numnahboom/rv32i_int8_dsc_cnn_accelerator/docs/reports/synthesis_vivado_ds_block_tile_engine_new.md

# Vivado Initial Synthesis Report

- Date: 2026-07-17T12:31:50+0800
- Tool: Vivado 2021.2
- Top module: `ds_block_tile_engine_new`
- Part: `xck26-sfvc784-2LV-c`
- Clock constraint: 10.000 ns
- Status: PASSED
- Timing summary: FAILED: ERROR: [Common 17-577] Internal error: Cannot run timing on a non-timing device

- Clock utilization report: FAILED: ERROR: [Common 17-577] Internal error: Cannot run timing on a non-timing device

- Checkpoint write: FAILED: ERROR: [Common 17-577] Internal error: Cannot run timing on a non-timing device

## Quick Counts

| Metric | Value |
| --- | ---: |
| LUT primitive cells | 29823 |
| FF/latch primitive cells | 15649 |
| BRAM-like primitive cells | 26 |
| DSP primitive cells | 14 |
| Worst observed max-path slack | unknown ns |

## Generated Reports

- `build/reports/vivado_ds_block_tile_engine_new/utilization.txt`
- `build/reports/vivado_ds_block_tile_engine_new/utilization_hierarchical.txt`
- `build/reports/vivado_ds_block_tile_engine_new/timing_summary.txt`
- `build/reports/vivado_ds_block_tile_engine_new/clock_utilization.txt`
- `build/reports/vivado_ds_block_tile_engine_new/ds_block_tile_engine_new_synth.dcp` if checkpoint write passed

## Notes

This is an initial synthesis-only result. It is not post-place-and-route timing and does not include board-level IO constraints.
