numnahboom/rv32i_int8_dsc_cnn_accelerator/docs/reports/synthesis_vivado_ds_block_tile_engine.md

# Vivado Initial Synthesis Report

- Date: 2026-06-16T16:20:15+0800
- Tool: Vivado 2021.2
- Top module: `ds_block_tile_engine`
- Part: `xck26-sfvc784-2LV-c`
- Clock constraint: 10.000 ns
- Status: PASSED
- Timing summary: FAILED: ERROR: [Common 17-577] Internal error: Cannot run timing on a non-timing device

- Clock utilization report: FAILED: ERROR: [Common 17-577] Internal error: Cannot run timing on a non-timing device

- Checkpoint write: FAILED: ERROR: [Common 17-577] Internal error: Cannot run timing on a non-timing device

## Quick Counts

| Metric | Value |
| --- | ---: |
| LUT primitive cells | 645195 |
| FF/latch primitive cells | 565654 |
| BRAM-like primitive cells | 0 |
| DSP primitive cells | 20 |
| Worst observed max-path slack | unknown ns |

## Generated Reports

- `build/reports/vivado_ds_block_tile_engine/utilization.txt`
- `build/reports/vivado_ds_block_tile_engine/utilization_hierarchical.txt`
- `build/reports/vivado_ds_block_tile_engine/timing_summary.txt`
- `build/reports/vivado_ds_block_tile_engine/clock_utilization.txt`
- `build/reports/vivado_ds_block_tile_engine/ds_block_tile_engine_synth.dcp` if checkpoint write passed

## Notes

This is an initial synthesis-only result. It is not post-place-and-route timing and does not include board-level IO constraints.
