numnahboom/rv32i_int8_dsc_cnn_accelerator/docs/reports/synthesis_vivado_dw_tile_fusion_engine.md

# Vivado Initial Synthesis Report

- Date: 2026-06-16T10:10:34+0800
- Tool: Vivado 2021.2
- Top module: `dw_tile_fusion_engine`
- Part: `xck26-sfvc784-2LV-c`
- Clock constraint: 10.000 ns
- Status: PASSED
- Timing summary: FAILED: ERROR: [Common 17-577] Internal error: Cannot run timing on a non-timing device

- Clock utilization report: FAILED: ERROR: [Common 17-577] Internal error: Cannot run timing on a non-timing device

- Checkpoint write: FAILED: ERROR: [Common 17-577] Internal error: Cannot run timing on a non-timing device

## Quick Counts

| Metric | Value |
| --- | ---: |
| LUT primitive cells | 307455 |
| FF/latch primitive cells | 296388 |
| BRAM-like primitive cells | 0 |
| DSP primitive cells | 10 |
| Worst observed max-path slack | unknown ns |

## Generated Reports

- `build/reports/vivado_dw_tile_fusion_engine/utilization.txt`
- `build/reports/vivado_dw_tile_fusion_engine/utilization_hierarchical.txt`
- `build/reports/vivado_dw_tile_fusion_engine/timing_summary.txt`
- `build/reports/vivado_dw_tile_fusion_engine/clock_utilization.txt`
- `build/reports/vivado_dw_tile_fusion_engine/dw_tile_fusion_engine_synth.dcp` if checkpoint write passed

## Notes

This is an initial synthesis-only result. It is not post-place-and-route timing and does not include board-level IO constraints.
