numnahboom/rv32i_int8_dsc_cnn_accelerator/docs/reports/assets/d4_asic_area_tradeoffs_20261020.pdf

Four partial
products

Native full
signed32
TT, 8 ns; mapped standard cells

0.00

0.02

0.04

0.06

0.08

Are

a (m

m2

)

0.0762

0.0619

18.70% smaller

### Isolated RQ lane

3 x 2048
words

2048/1024/2048
words
Exact LEF/Liberty placement boundary

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
a (m

m2

)

4.7156

4.0426

14.27% smaller

### Activation SRAM footprint

A2: logic
residual table

A3: 8 compiled
residual ROMs
TT, 10 ns; synthesis only

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
ell are

a (m

m2

)

9.1052

9.9230

+8.98% total

### Complete core, all storage counted

Memory macros
Combinational
Sequential

## D4 / SMIC 180 nm: measured implementation trade-offs

Same frozen network and integer semantics. Separate area scopes; no power or post-route claim. A2 numeric mapping reports retained; its mapped checkpoint was not saved. A3 checkpoint and report recovery verified.
