numnahboom/rv32i_int8_dsc_cnn_accelerator/docs/reports/assets/d4_mop_route_comparison_20261019.pdf

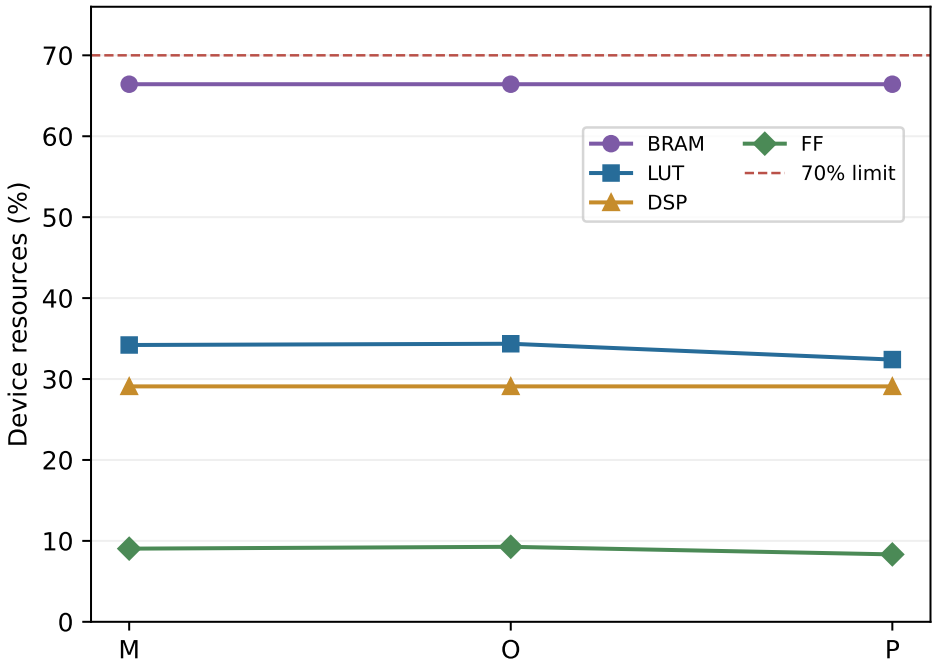
[picture p2: figure]
Device resources (%); BRAM LUT DSP; FF 70% limit

M | O | P

0.3

0.2

0.1

0.0

0.1

0.2

Post-route setup WNS (ns)

-0.287 ns

-0.221 ns

+0.128 ns

### 125 MHz synchronous setup

### Each resource stays below 70%

D4 full-route evidence: M | O | P
