numnahboom/rv32i_int8_dsc_cnn_accelerator/docs/reports/pw_partial_k_streaming_20260830.md

# PW output-stationary partial-K streaming prototype

Date: 2026-08-30  
Device: `xc7z020clg400-1`  
Clock screen: 8 ns (125 MHz)

## Scope

This is an isolated prototype for `pw_systolic_array_8x8`; it is not connected
to `ds_block_tile_engine_new`, the layer runner, or the full network. The
external block remains an 8-pixel x 8-cout transaction. The physical fabric is
8 x 4 and uses two output-channel halves.

The lower half now consumes each accepted K token immediately while a narrow
replay memory retains the token for the upper half. `first_k`/`last_k` describe
the complete reduction, while `k_group`/`k_count` describe a group. Group
boundaries never clear, close, requantize, or publish the accumulator. The
lower PE sums are captured into `first_psum` only after the final lower token's
registered PE update; the upper replay then clears the PE fabric exactly once
on its first token and retains its psum across all group boundaries. Legacy
`clear_acc`/`k_last` remains selected when `k_count==0`.
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
