numnahboom/rv32i_int8_dsc_cnn_accelerator/tests/fixtures/d4_activity_binding/fd_q_hierarchy_bindings.tsv

source_scope | physical_scope | expected_orig_ref | expected_parent
u_core/rq_mul_lanes[0]/rq_mul | u_core/rq_mul_lanes[0].rq_mul | d4_rq_partial_multiplier_lane | u_core
u_core/rq_mul_lanes[1]/rq_mul | u_core/rq_mul_lanes[1].rq_mul | d4_rq_partial_multiplier_lane | u_core
u_core/rq_mul_lanes[2]/rq_mul | u_core/rq_mul_lanes[2].rq_mul | d4_rq_partial_multiplier_lane | u_core
u_core/rq_mul_lanes[3]/rq_mul | u_core/rq_mul_lanes[3].rq_mul | d4_rq_partial_multiplier_lane | u_core
u_core/rq_mul_lanes[4]/rq_mul | u_core/rq_mul_lanes[4].rq_mul | d4_rq_partial_multiplier_lane | u_core
u_core/rq_mul_lanes[5]/rq_mul | u_core/rq_mul_lanes[5].rq_mul | d4_rq_partial_multiplier_lane | u_core
u_core/rq_mul_lanes[6]/rq_mul | u_core/rq_mul_lanes[6].rq_mul | d4_rq_partial_multiplier_lane | u_core
u_core/rq_mul_lanes[7]/rq_mul | u_core/rq_mul_lanes[7].rq_mul | d4_rq_partial_multiplier_lane | u_core
u_core/rq_mul_lanes[8]/rq_mul | u_core/rq_mul_lanes[8].rq_mul | d4_rq_partial_multiplier_lane | u_core
u_core/rq_mul_lanes[9]/rq_mul | u_core/rq_mul_lanes[9].rq_mul | d4_rq_partial_multiplier_lane | u_core
u_core/rq_mul_lanes[10]/rq_mul | u_core/rq_mul_lanes[10].rq_mul | d4_rq_partial_multiplier_lane | u_core
u_core/rq_mul_lanes[11]/rq_mul | u_core/rq_mul_lanes[11].rq_mul | d4_rq_partial_multiplier_lane | u_core
u_core/rq_mul_lanes[12]/rq_mul | u_core/rq_mul_lanes[12].rq_mul | d4_rq_partial_multiplier_lane | u_core
u_core/rq_mul_lanes[13]/rq_mul | u_core/rq_mul_lanes[13].rq_mul | d4_rq_partial_multiplier_lane | u_core
u_core/rq_mul_lanes[14]/rq_mul | u_core/rq_mul_lanes[14].rq_mul | d4_rq_partial_multiplier_lane | u_core
u_core/rq_mul_lanes[15]/rq_mul | u_core/rq_mul_lanes[15].rq_mul | d4_rq_partial_multiplier_lane | u_core
