numnahboom/rv32i_int8_dsc_cnn_accelerator/rtl/cnn/ds12_stream_ds1_layer.v

`timescale 1ns/1ps
`default_nettype none
module ds12_stream_ds1_layer #(
    parameter integer INPUT_BASE = 0,
    parameter integer SINK_BASE = 32'h00100000
) (
    input wire clk,input wire rst_n,input wire start,
    output wire cfg_mem_req_valid,input wire cfg_mem_req_ready,output wire [31:0] cfg_mem_req_addr,output wire [3:0] cfg_mem_req_strb,output wire [1:0] cfg_mem_req_layer,output wire [15:0] cfg_mem_req_word_index,input wire cfg_mem_resp_valid,input wire [31:0] cfg_mem_resp_data,
    output wire input_mem_req_valid,input wire input_mem_req_ready,output wire input_mem_req_write,output wire [31:0] input_mem_req_addr,output wire [127:0] input_mem_req_wdata,output wire [15:0] input_mem_req_strb,output wire [1:0] input_mem_req_context,output wire input_mem_req_owner,output wire [31:0] input_mem_req_epoch,input wire input_mem_resp_valid,input wire [127:0] input_mem_resp_data,
    output wire output_write_valid,input wire output_ready,output wire output_write_bank,output wire [31:0] output_write_epoch,output wire [31:0] output_write_addr,output wire [31:0] output_write_data,output wire [3:0] output_write_be,output wire output_write_last,
    output wire layer_done,output wire error,output wire ds1_config_done,output wire ds2_preload_done,output wire [31:0] cycle_count,output wire [31:0] dw_first_cycle,output wire [31:0] dw_last_cycle,output wire [31:0] pw_first_cycle,output wire [31:0] pw_last_cycle,output wire [31:0] overlap_cycles,output wire [31:0] dw_idle_cycles,output wire [31:0] pw_idle_cycles,output wire [31:0] dw_mac_count,output wire [31:0] pw_mac_count,output wire [31:0] output_word_count,output wire [31:0] config_read_count,output wire [31:0] config_write_count,output wire [1:0] active_config_layer,output wire [31:0] active_config_epoch,output wire active_config_bank,output wire [1:0] activation_bank0_state,output wire [1:0] activation_bank1_state,output wire [31:0] activation_write_count,output wire activation_commit_done,output wire [31:0] activation_write_expected_bytes,output wire activation_write_last_seen,output wire [31:0] ds1_input_read_count,output wire [31:0] ds1_dw_vector_count
);
  wire d_clv,d_clr; wire [1:0] d_cllayer; wire [31:0] d_cle; wire [15:0] d_clcount;
  wire c_req_v,c_req_r,c_resp_r,c_rd_en,c_rd_v,c_rd_bank,c_load_done,c_err,c_act_valid; wire [31:0] c_req_addr,c_rd_data,c_act_epoch; wire [3:0] c_req_strb,c_errcode; wire [15:0] c_req_idx,c_rd_addr; wire [1:0] c_act_layer,c_bank_valid; wire c_act_bank,c_busy; wire [15:0] c_issued,c_received;
  function automatic [31:0] src_addr(input [1:0] l,input [15:0] i);
    begin if(l==1) begin if(i<36)src_addr=32'h3000+i*4; else if(i<52)src_addr=32'h3100+(i-36)*4; else if(i<68)src_addr=32'h3140+(i-52)*4; else if(i<84)src_addr=32'h3180+(i-68)*4; else if(i<212)src_addr=32'h3200+(i-84)*4; else if(i<244)src_addr=32'h3400+(i-212)*4; else if(i<276)src_addr=32'h3480+(i-244)*4; else src_addr=32'h3500+(i-276)*4; end else begin if(i<72)src_addr=32'h4000+i*4; else if(i<104)src_addr=32'h4200+(i-72)*4; else if(i<136)src_addr=32'h4280+(i-104)*4; else if(i<168)src_addr=32'h4300+(i-136)*4; else if(i<424)src_addr=32'h4400+(i-168)*4; else if(i<488)src_addr=32'h4c00+(i-424)*4; else if(i<552)src_addr=32'h4d00+(i-488)*4; else src_addr=32'h4e00+(i-552)*4; end end
  endfunction
  assign cfg_mem_req_valid=c_req_v; assign cfg_mem_req_addr=src_addr(d_cllayer,c_req_idx); assign cfg_mem_req_strb=c_req_strb; assign cfg_mem_req_layer=d_cllayer; assign cfg_mem_req_word_index=c_req_idx; assign c_req_r=cfg_mem_req_ready;
  ds12_stream_config_banks cfg(.clk(clk),.rst_n(rst_n),.start(d_clv),.start_layer(d_cllayer),.start_base_addr(0),.start_word_count(d_clcount),.start_epoch(d_cle),.start_ready(d_clr),.mem_req_valid(c_req_v),.mem_req_ready(c_req_r),.mem_req_addr(c_req_addr),.mem_req_strb(c_req_strb),.mem_req_word_index(c_req_idx),.mem_resp_valid(cfg_mem_resp_valid),.mem_resp_ready(c_resp_r),.mem_resp_rdata(cfg_mem_resp_data),.commit_req(0),.clear_error(0),.cfg_rd_en(c_rd_en),.cfg_rd_bank(c_rd_bank),.cfg_rd_addr(c_rd_addr),.cfg_rd_data(c_rd_data),.cfg_rd_valid(c_rd_v),.busy(c_busy),.active_bank(c_act_bank),.active_layer(c_act_layer),.active_epoch(c_act_epoch),.active_valid(c_act_valid),.bank_valid(c_bank_valid),.expected_count(),.issued_count(c_issued),.received_count(c_received),.load_crc32(),.load_done(c_load_done),.error(c_err),.error_code(c_errcode));
  wire d_rd_v,d_rd_r,d_resp_v; wire [15:0] d_rd_addr; wire [31:0] d_resp_data; wire d_pf_v,d_pf_r; wire [1:0] d_pf_l; wire [31:0] d_pf_e; wire [15:0] d_pf_n; reg d2_done;
  wire d_as_v,d_as_r,d_aw_v,d_aw_r,d_aw_bank,d_aw_last,d_aw_drain,d_commit_v,d_commit_ack; wire [31:0] d_aw_addr,d_aw_data,d_aw_epoch,d_aw_count,d_owner_epoch,d_cfg_reads,d_cfg_writes; wire [3:0] d_aw_be; wire [1:0] d_owner;
  wire a_start_r,a_write_r,a_commit_done,a_err,a_last; wire [1:0] a_b0,a_b1; wire [31:0] a_wc,a_we;
  assign d_rd_r=1'b1; assign c_rd_en=d_rd_v; assign c_rd_bank=c_act_bank; assign c_rd_addr=d_rd_addr; assign d_resp_v=c_rd_v; assign d_resp_data=c_rd_data; assign d_pf_r=d_clr; assign d_as_r=a_start_r; assign d_aw_r=a_write_r&&output_ready; assign d_commit_ack=a_commit_done;
  ds12_stream_ds1_datapath #(.INPUT_BASE(INPUT_BASE),.SINK_BASE(SINK_BASE)) dp(.clk(clk),.rst_n(rst_n),.start(start),.cfg_load_req_valid(d_clv),.cfg_load_req_ready(d_clr),.cfg_load_req_layer(d_cllayer),.cfg_load_req_epoch(d_cle),.cfg_load_req_count(d_clcount),.cfg_load_done(c_load_done),.cfg_error(c_err),.cfg_active_rd_valid(d_rd_v),.cfg_active_rd_ready(d_rd_r),.cfg_active_rd_addr(d_rd_addr),.cfg_active_rd_resp_valid(d_resp_v),.cfg_active_rd_resp_data(d_resp_data),.ds2_prefetch_req_valid(d_pf_v),.ds2_prefetch_req_ready(d_pf_r),.ds2_prefetch_req_layer(d_pf_l),.ds2_prefetch_req_epoch(d_pf_e),.ds2_prefetch_req_count(d_pf_n),.ds2_prefetch_done(d2_done),.input_mem_req_valid(input_mem_req_valid),.input_mem_req_ready(input_mem_req_ready),.input_mem_req_write(input_mem_req_write),.input_mem_req_addr(input_mem_req_addr),.input_mem_req_wdata(input_mem_req_wdata),.input_mem_req_strb(input_mem_req_strb),.input_mem_req_context(input_mem_req_context),.input_mem_req_owner(input_mem_req_owner),.input_mem_req_epoch(input_mem_req_epoch),.input_mem_resp_valid(input_mem_resp_valid),.input_mem_resp_data(input_mem_resp_data),.activation_start_valid(d_as_v),.activation_start_ready(d_as_r),.activation_write_valid(d_aw_v),.activation_write_ready(d_aw_r),.activation_write_addr(d_aw_addr),.activation_write_data(d_aw_data),.activation_write_be(d_aw_be),.activation_write_last(d_aw_last),.activation_write_bank(d_aw_bank),.activation_write_epoch(d_aw_epoch),.activation_write_count(d_aw_count),.activation_write_drain(d_aw_drain),.activation_commit_req(d_commit_v),.activation_commit_ack(d_commit_ack),.activation_owner(d_owner),.activation_epoch(d_owner_epoch),.layer_done(layer_done),.error(error),.ds1_config_done(ds1_config_done),.ds2_preload_done(ds2_preload_done),.cycle_count(cycle_count),.dw_first_cycle(dw_first_cycle),.dw_last_cycle(dw_last_cycle),.pw_first_cycle(pw_first_cycle),.pw_last_cycle(pw_last_cycle),.overlap_cycles(overlap_cycles),.dw_idle_cycles(dw_idle_cycles),.pw_idle_cycles(pw_idle_cycles),.dw_mac_count(dw_mac_count),.pw_mac_count(pw_mac_count),.output_word_count(output_word_count),.config_read_count(d_cfg_reads),.config_write_count(d_cfg_writes),.ds1_input_read_count(ds1_input_read_count),.ds1_dw_vector_count(ds1_dw_vector_count));
  assign output_write_valid=d_aw_v&&output_ready; assign output_write_bank=d_aw_bank; assign output_write_epoch=d_aw_epoch; assign output_write_addr=d_aw_addr; assign output_write_data=d_aw_data; assign output_write_be=d_aw_be; assign output_write_last=d_aw_last;
  ds12_stream_dual_vector_activation_store #(.LINE_WORDS(2048)) act(.clk(clk),.rst_n(rst_n),.layer_start_valid(d_as_v),.layer_start_ready(a_start_r),.layer_start_bank(1),.layer_start_epoch(1),.layer_start_expected_words(8192),.write_valid(d_aw_v&&output_ready),.write_ready(a_write_r),.write_bank(d_aw_bank),.write_epoch(d_aw_epoch),.write_addr(d_aw_addr),.write_data(d_aw_data),.write_be(d_aw_be),.write_last(d_aw_last),.write_resp_valid(),.write_resp_ready(1),.write_resp_bank(),.write_resp_epoch(),.write_resp_addr(),.layer_end_valid(0),.layer_end_ready(),.layer_end_bank(0),.layer_end_epoch(0),.commit_valid(d_commit_v),.commit_ready(),.commit_bank(d_owner[0]),.commit_epoch(d_owner_epoch),.commit_done(a_commit_done),.layer_end_done(),.atomic_swap(),.read_req_valid(0),.read_req_ready(),.read_req_bank(0),.read_req_epoch(0),.read_req_addr(0),.read_resp_valid(),.read_resp_ready(1),.read_resp_data(),.read_resp_bank(),.read_resp_epoch(),.read_resp_addr(),.bank0_state(a_b0),.bank1_state(a_b1),.bank0_epoch(),.bank1_epoch(),.active_read_bank(),.active_read_epoch(),.active_write(),.active_write_bank(),.write_epoch_active(),.write_count(a_wc),.write_expected_words(a_we),.write_last_seen(a_last),.error(a_err),.error_code());
  assign activation_bank0_state=a_b0; assign activation_bank1_state=a_b1; assign activation_write_count=a_wc<<2; assign activation_write_expected_bytes=a_we<<2; assign activation_write_last_seen={31'd0,a_last}; assign activation_commit_done=commit_seen; assign active_config_layer=c_act_layer; assign active_config_epoch=c_act_epoch; assign active_config_bank=c_act_bank;
  reg d2_started;
  reg [31:0] cfg_total;
  reg commit_seen;
  assign config_read_count=cfg_total;
  assign config_write_count=cfg_total;
  always @(posedge clk) begin
    if(!rst_n) begin d2_done<=1'b0; d2_started<=1'b0; cfg_total<=0; commit_seen<=1'b0; end
    else begin
      if(d_pf_v&&d_pf_r) d2_started<=1'b1;
      if(c_load_done && (d2_started || c_act_layer==2)) d2_done<=1'b1;
      if(c_load_done) cfg_total <= cfg_total + ((d2_started || c_act_layer==2) ? 32'd872 : 32'd308);
      if(a_commit_done) commit_seen<=1'b1;
    end
  end
endmodule
`default_nettype wire
