numnahboom/rv32i_int8_dsc_cnn_accelerator/rtl/cnn/ds12_stream_ds2_pw_consumer.v

`timescale 1ns/1ps
`default_nettype none

/*
 * Stand-alone DS2 pointwise consumer.
 *
 * The DW endpoint presents two 16-byte activation slices for each pixel.
 * Eight adjacent pixels form one PW context, so the input side keeps only
 * the bounded activation scratch and its sixteen slice-valid bits.  The PW
 * engine itself is an 8x8 output-stationary array: one accepted K token
 * performs 8*8 = 64 signed INT8 MACs and K=0..31 is issued on consecutive
 * cycles.  The 64 local INT32 sums are reused for each Cout tile; at K=31
 * their *next* values are written to the selected result bank.  Consequently
 * the final product is present before a bank can become drainable.
 *
 * Two result banks provide the compute/drain ownership fence.  Each lifecycle
 * bank is 64 independent shallow depth-8 x 32-bit lane memories (not a
 * layer-sized accumulator array): one completed context can remain stable
 * under sink backpressure while the other bank accepts the next context.  A
 * bank is released only by the final accepted sink word, and contexts are
 * drained in group order so sink_last cannot be asserted early by an
 * out-of-order DW arrival.
 */
module ds12_stream_ds2_pw_consumer #(
    parameter integer PIXELS = 256,
    parameter integer CONTEXTS = 32,
    parameter integer CONTEXT_PIXELS = 8,
    parameter [31:0] SINK_BASE = 32'h00200000
) (
    input wire clk, input wire rst_n,
    input wire start, output wire ready,

    // Synchronous read port of the real packed DS2 configuration bank.
    // Local indices 0..703 map to packed bank words 168..871.
    output wire cfg_rd_en, output wire cfg_rd_bank,
    output wire [15:0] cfg_rd_addr, input wire [31:0] cfg_rd_data,
    input wire cfg_rd_valid, input wire cfg_active_valid,
    input wire [1:0] cfg_active_layer, input wire cfg_active_bank,
    input wire [31:0] cfg_active_epoch,
    output wire [15:0] config_index, output wire [31:0] config_payload,

    input wire dw_valid, output wire dw_ready,
    input wire [127:0] dw_data, input wire [5:0] dw_row,
    input wire [7:0] dw_pixel, input wire dw_group,
    input wire [1:0] dw_context, input wire dw_owner,
    input wire [31:0] dw_epoch, input wire dw_last,

    output wire sink_valid, input wire sink_ready,
    output wire [31:0] sink_addr, output wire [31:0] sink_data,
    output wire [3:0] sink_strb, output wire [5:0] sink_row,
    output wire [7:0] sink_pixel, output wire [3:0] sink_word_in_pixel,
    output wire [1:0] sink_context, output wire sink_owner,
    output wire [31:0] sink_epoch, output wire sink_last,

    output wire busy, output wire done, output wire error,
    output wire [7:0] error_code,
    output wire [31:0] cfg_read_count, output wire [31:0] cfg_weight_read_count,
    output wire [31:0] dw_vector_count, output wire [31:0] pw_token_count,
    output wire [31:0] pw_mac_count, output wire [31:0] output_word_count,
    output wire [3:0] partial_context_peak
);
    localparam [2:0] ST_IDLE      = 3'd0;
    localparam [2:0] ST_CFG_ISSUE = 3'd1;
    localparam [2:0] ST_CFG_WAIT  = 3'd2;
    localparam [2:0] ST_RUN       = 3'd3;

    localparam [2:0] SLOT_IDLE     = 3'd0;
    localparam [2:0] SLOT_FILL     = 3'd1;
    localparam [2:0] SLOT_READY    = 3'd2;
    localparam [2:0] SLOT_COMPUTE  = 3'd3;
    localparam [2:0] SLOT_WAIT_OUT = 3'd4;

    localparam [1:0] BANK_FREE    = 2'd0;
    localparam [1:0] BANK_COMPUTE = 2'd1;
    localparam [1:0] BANK_READY   = 2'd2;
    localparam [1:0] BANK_DRAIN   = 2'd3;

    localparam integer EXPECTED_OUTPUTS = PIXELS * 16;
    localparam [15:0] CFG_BASE_WORD = 16'd168;
    localparam [9:0] CFG_LAST_INDEX = 10'd703;
    localparam [6:0] LAST_OUTPUT_WORD = 7'd127;
    localparam [8:0] PIXELS_LIMIT = 9'd256;
    localparam [5:0] CONTEXTS_LIMIT = 6'd32;
    localparam [7:0] LAST_PIXEL = 8'd255;

    reg [2:0] state;
    reg [9:0] cfg_index_r;
    reg cfg_bank_r;
    reg [31:0] cfg_epoch_r;
    reg cfg_done_r, done_r, error_r;
    reg [7:0] error_code_r;

    reg signed [31:0] bias [0:63];
    reg signed [31:0] multiplier [0:63];
    reg [5:0] shift [0:63];

    // Input activation ledger.  The payload itself lives in eight independent
    // synchronous BRAM read/write banks below: one 64 x 128-bit bank per
    // pixel lane.  The six-bit row address is {pixel-group[4:0],slice}, so a
    // DW fire writes one complete 128-bit slice without any byte enables.
    //
    // The 32-context tag ledger is deliberately partitioned into four local
    // 8-context banks.  Each bank owns its state/context/owner/epoch/seen
    // arrays and performs its own selected-entry compare/update.  The top
    // level only decodes input_group[4:3] (and the ordered target group) to
    // select one bank; it never indexes one global 32-entry ledger.
    wire [2:0] ledger_input_state [0:3];
    wire [1:0] ledger_input_context [0:3];
    wire ledger_input_owner [0:3];
    wire [31:0] ledger_input_epoch [0:3];
    wire [15:0] ledger_input_seen [0:3];
    wire ledger_input_slot_existing [0:3];
    wire ledger_input_tag_match [0:3];
    wire ledger_input_slice_available [0:3];
    wire ledger_input_ready [0:3];
    // The ingress selector is one-hot.  Gating DW valid before it enters a
    // local bank keeps non-selected banks out of the input handshake/update
    // cone; their slot/seen/tag state cannot observe another bank's fire.
    wire [3:0] input_bank_selected;
    wire [3:0] bank_dw_valid;
    wire [3:0] bank_dw_fire;
    wire [2:0] ledger_target_state [0:3];
    wire [1:0] ledger_target_context [0:3];
    wire ledger_target_owner [0:3];
    wire [31:0] ledger_target_epoch [0:3];
    wire [3:0] ledger_active_count [0:3];

    // Each generated memory has one write port (DW slice) and one independent
    // synchronous read port (compute prefetch).  A 64 x 128-bit logical bank
    // maps to four RAMB18 primitives (or two RAMB36 primitives) on the
    // XC7Z020; eight lane banks therefore account for 32 RAMB18/16 RAMB36.
    // The memory array is intentionally not reset, preserving block-RAM
    // inference.  A compute claim always issues the first read before any
    // prefetched byte is consumed.
    reg [127:0] activation_prefetch [0:CONTEXT_PIXELS-1];

    // Eight Cout-lane weight memories hold one 32-bit word for each
    // {Cout-tile,K-byte-group}.  The packed configuration stream is ordered
    // by Cout first and four K bytes per word: cfg index bits [8:3] are the
    // original Cout, so [5:3] selects the lane and [8:6] plus [2:0] form the
    // tile/K-group depth address.  Keeping the memories as separate 64 x 32
    // block-RAM candidates avoids rebuilding 16,384 weight bits as registers
    // while preserving the original word-write interface.
    wire [255:0] weight_prefetch_bus;

    // The DW boundary is intentionally a one-entry ingress/commit pipeline.
    // A vector is accepted into these registers on one edge and committed to
    // activation BRAM on the next edge.  Because the old entry is committed
    // on the same edge that a new entry is captured, the external DW stream
    // still has II=1.  Keeping the BRAM write enable registered removes the
    // slot tag/epoch compare from the RAMB WEBWE timing cone.
    reg dw_ingress_pending;
    reg [127:0] dw_ingress_data;
    reg [5:0] dw_ingress_row;
    reg [7:0] dw_ingress_pixel;
    reg [4:0] dw_ingress_group;
    reg [2:0] dw_ingress_local_pixel;
    reg dw_ingress_slice;
    reg [1:0] dw_ingress_context;
    reg dw_ingress_owner;
    reg [31:0] dw_ingress_epoch;
    reg dw_ingress_last;
    reg dw_ingress_final;

    // The 64 lane accumulators are the P registers of explicit DSP48E1
    // wrappers.  There is no ordinary external register in the K feedback
    // loop: each DSP receives its own P output on PCIN and has PREG=1.
    // Results are committed through one controlled two-edge pending drain
    // after K=31 so the final product can cross the DSP A/B input registers
    // and PREG before the result BRAM write.
    wire signed [47:0] dsp_accum [0:63];
    reg [1:0] bank_state [0:1];
    reg [4:0] bank_group [0:1];
    reg [1:0] bank_context [0:1];
    reg bank_owner [0:1];
    reg [31:0] bank_epoch [0:1];

    reg compute_active;
    reg [4:0] compute_slot;
    reg compute_bank;
    reg [7:0] compute_step;
    reg last_pending;
    reg result_pending;
    reg output_active;
    reg output_bank;
    reg [6:0] output_word;
    reg [5:0] next_output_group;

    reg [31:0] cfg_read_count_r, cfg_weight_read_count_r;
    reg [31:0] dw_vector_count_r, pw_token_count_r, pw_mac_count_r;
    reg [31:0] output_word_count_r;
    reg [3:0] partial_context_peak_r;

    integer i, j;

    wire [4:0] input_group = dw_pixel[7:3];
    wire [2:0] input_local_pixel = dw_pixel[2:0];
    wire [3:0] input_bit_index = {input_local_pixel, 1'b0} +
                                  {{3{1'b0}}, dw_group};
    wire input_group_valid = ({1'b0, dw_pixel} < PIXELS_LIMIT) &&
                             ({1'b0, input_group} < CONTEXTS_LIMIT);
    wire [5:0] target_group = output_active ?
        (next_output_group + 6'd1) : next_output_group;
    reg input_slot_existing;
    reg input_tag_match;
    reg input_slice_available;
    reg [2:0] input_state;
    reg [15:0] input_seen;
    reg [5:0] active_context_count;

    wire target_group_valid = (target_group < CONTEXTS_LIMIT);
    reg target_ready;
    reg [2:0] target_state;
    reg [1:0] target_context;
    reg target_owner;
    reg [31:0] target_epoch;
    reg compute_pick_valid;
    reg compute_pick_bank;
    reg [4:0] compute_pick_slot;
    reg output_pick_valid;
    reg output_pick_bank;

    wire run_active = (state == ST_RUN);
    wire [31:0] expected_outputs = EXPECTED_OUTPUTS;
    wire [5:0] expected_dw_row = {2'd0, dw_pixel[7:4]};
    wire dw_fire;
    wire dw_commit_fire = dw_ingress_pending;
    wire sink_fire;
    wire prefetch_req;
    wire [5:0] prefetch_addr;
    wire weight_prefetch_req;
    wire [5:0] weight_prefetch_addr;

    // Decode the 32-entry global context index into exactly one of the four
    // local 8-slot ledger banks.  An invalid pixel selects no bank and is
    // still handled by the sticky protocol-error checks below.
    assign input_bank_selected[0] = input_group_valid &&
                                    (input_group[4:3] == 2'd0);
    assign input_bank_selected[1] = input_group_valid &&
                                    (input_group[4:3] == 2'd1);
    assign input_bank_selected[2] = input_group_valid &&
                                    (input_group[4:3] == 2'd2);
    assign input_bank_selected[3] = input_group_valid &&
                                    (input_group[4:3] == 2'd3);
    assign bank_dw_valid[0] = dw_valid && input_bank_selected[0];
    assign bank_dw_valid[1] = dw_valid && input_bank_selected[1];
    assign bank_dw_valid[2] = dw_valid && input_bank_selected[2];
    assign bank_dw_valid[3] = dw_valid && input_bank_selected[3];

    wire run_start = (state == ST_IDLE) && start && cfg_done_r &&
                     cfg_active_valid && (cfg_active_layer == 2'd2) &&
                     (cfg_active_epoch == cfg_epoch_r);

    // Decode the group before selecting one local ledger bank.  This keeps
    // malformed pixels out of the local indices and gives a single handshake
    // source without a global 32-entry tag/seen mux.
    always @* begin
        input_slot_existing = 1'b0;
        input_tag_match = 1'b0;
        input_slice_available = 1'b0;
        input_state = SLOT_IDLE;
        input_seen = 16'd0;
        if (input_group_valid) begin
            case (input_group[4:3])
                2'd0: begin
                    input_state = ledger_input_state[0];
                    input_seen = ledger_input_seen[0];
                    input_slot_existing = ledger_input_slot_existing[0];
                    input_tag_match = ledger_input_tag_match[0];
                    input_slice_available = ledger_input_slice_available[0];
                end
                2'd1: begin
                    input_state = ledger_input_state[1];
                    input_seen = ledger_input_seen[1];
                    input_slot_existing = ledger_input_slot_existing[1];
                    input_tag_match = ledger_input_tag_match[1];
                    input_slice_available = ledger_input_slice_available[1];
                end
                2'd2: begin
                    input_state = ledger_input_state[2];
                    input_seen = ledger_input_seen[2];
                    input_slot_existing = ledger_input_slot_existing[2];
                    input_tag_match = ledger_input_tag_match[2];
                    input_slice_available = ledger_input_slice_available[2];
                end
                default: begin
                    input_state = ledger_input_state[3];
                    input_seen = ledger_input_seen[3];
                    input_slot_existing = ledger_input_slot_existing[3];
                    input_tag_match = ledger_input_tag_match[3];
                    input_slice_available = ledger_input_slice_available[3];
                end
            endcase
        end
    end

    genvar lb;
    generate
        for (lb = 0; lb < 4; lb = lb + 1) begin : gen_slot_ledger_bank
            localparam [1:0] LEDGER_BANK = lb[1:0];
            ds12_stream_ds2_slot_ledger_bank u_ledger (
            .clk(clk),
            .rst_n(rst_n),
            .clear_slots(run_start),
                .input_query_valid(input_bank_selected[lb]),
                .input_query_slot(input_group[2:0]),
                .input_query_context(dw_context),
                .input_query_owner(dw_owner),
                .input_query_epoch(dw_epoch),
                .input_query_bit(input_bit_index),
                .input_state(ledger_input_state[lb]),
                .input_context(ledger_input_context[lb]),
                .input_owner(ledger_input_owner[lb]),
                .input_epoch(ledger_input_epoch[lb]),
                .input_seen(ledger_input_seen[lb]),
                .input_slot_existing(ledger_input_slot_existing[lb]),
                .input_tag_match(ledger_input_tag_match[lb]),
                .input_slice_available(ledger_input_slice_available[lb]),
                .stream_active(run_active),
                .ingress_available(!dw_ingress_pending || dw_commit_fire),
                .dw_valid(bank_dw_valid[lb]),
                .input_ready(ledger_input_ready[lb]),
                .input_fire(bank_dw_fire[lb]),
                .target_query_valid(target_group_valid &&
                                    (target_group[4:3] == LEDGER_BANK)),
                .target_query_slot(target_group[2:0]),
                .target_state(ledger_target_state[lb]),
                .target_context(ledger_target_context[lb]),
                .target_owner(ledger_target_owner[lb]),
                .target_epoch(ledger_target_epoch[lb]),
                .active_count(ledger_active_count[lb]),
                .set_ready_valid(dw_commit_fire && dw_ingress_final &&
                                  (dw_ingress_group[4:3] == LEDGER_BANK)),
                .set_ready_slot(dw_ingress_group[2:0]),
                .set_compute_valid(compute_pick_valid &&
                                   (compute_pick_slot[4:3] == LEDGER_BANK)),
                .set_compute_slot(compute_pick_slot[2:0]),
                .set_wait_valid(compute_active &&
                                (compute_step == 8'd255) &&
                                (compute_slot[4:3] == LEDGER_BANK)),
                .set_wait_slot(compute_slot[2:0]),
                .release_valid(sink_fire &&
                               (output_word == LAST_OUTPUT_WORD) &&
                               (bank_group[output_bank][4:3] == LEDGER_BANK)),
                .release_slot(bank_group[output_bank][2:0])
            );
        end
    endgenerate

    assign ready = rst_n && (state == ST_IDLE) &&
                   cfg_active_valid && (cfg_active_layer == 2'd2);
    assign busy = (state != ST_IDLE) || compute_active || last_pending ||
                  result_pending || output_active;
    assign done = done_r;
    assign error = error_r;
    assign error_code = error_code_r;
    assign cfg_read_count = cfg_read_count_r;
    assign cfg_weight_read_count = cfg_weight_read_count_r;
    assign dw_vector_count = dw_vector_count_r;
    assign pw_token_count = pw_token_count_r;
    assign pw_mac_count = pw_mac_count_r;
    assign output_word_count = output_word_count_r;
    assign partial_context_peak = partial_context_peak_r;

    assign cfg_rd_en = (state == ST_CFG_ISSUE);
    assign cfg_rd_bank = cfg_bank_r;
    assign cfg_rd_addr = CFG_BASE_WORD + {{6{1'b0}}, cfg_index_r};
    assign config_index = CFG_BASE_WORD + {{6{1'b0}}, cfg_index_r};
    assign config_payload = cfg_rd_data;

    // The selected local ledger bank owns the tag compare, duplicate-slice
    // filter, and ingress-availability check.  ORing the one-hot bank results
    // keeps the accept/update path in that bank instead of routing it back
    // through a parent-wide 32-slot write decoder; exactly one bank can fire
    // for a legal input_group.
    // Only the selected bank contributes to the external ready/fire.  The
    // one-hot bank_dw_fire signals are the local valid/ready handshakes and
    // are mutually exclusive for every legal input_group.
    assign dw_ready = rst_n &&
        ((input_bank_selected[0] && ledger_input_ready[0]) ||
         (input_bank_selected[1] && ledger_input_ready[1]) ||
         (input_bank_selected[2] && ledger_input_ready[2]) ||
         (input_bank_selected[3] && ledger_input_ready[3]));
    assign dw_fire = bank_dw_fire[0] || bank_dw_fire[1] ||
                     bank_dw_fire[2] || bank_dw_fire[3];

    function automatic signed [7:0] requant;
        input signed [31:0] acc_value, bias_value, mult_value;
        input [5:0] shift_value;
        reg signed [32:0] x;
        reg signed [64:0] product, rounded, shifted, q;
        begin
            x = acc_value + bias_value;
            product = x * mult_value;
            if (product < 0)
                rounded = -(((-product) + 65'sd1073741824) >>> 31);
            else
                rounded = (product + 65'sd1073741824) >>> 31;
            shifted = rounded >>> shift_value;
            q = shifted;                         // DS2 output zero point = 0
            if (q < 0) q = 0;                     // activation clamp [0,127]
            else if (q > 127) q = 127;
            requant = q[7:0];
        end
    endfunction

    // The target is deliberately ordered.  While group N drains, only N+1
    // may compute; otherwise two later ready banks could starve an incomplete
    // earlier group and deadlock the ordered sink.
    wire bank0_free = (bank_state[0] == BANK_FREE);
    wire bank1_free = (bank_state[1] == BANK_FREE);
    wire free_bank_available = bank0_free || bank1_free;

    always @* begin
        target_state = SLOT_IDLE;
        target_context = 2'd0;
        target_owner = 1'b0;
        target_epoch = 32'd0;
        target_ready = 1'b0;
        if (target_group_valid) begin
            case (target_group[4:3])
                2'd0: begin
                    target_state = ledger_target_state[0];
                    target_context = ledger_target_context[0];
                    target_owner = ledger_target_owner[0];
                    target_epoch = ledger_target_epoch[0];
                end
                2'd1: begin
                    target_state = ledger_target_state[1];
                    target_context = ledger_target_context[1];
                    target_owner = ledger_target_owner[1];
                    target_epoch = ledger_target_epoch[1];
                end
                2'd2: begin
                    target_state = ledger_target_state[2];
                    target_context = ledger_target_context[2];
                    target_owner = ledger_target_owner[2];
                    target_epoch = ledger_target_epoch[2];
                end
                default: begin
                    target_state = ledger_target_state[3];
                    target_context = ledger_target_context[3];
                    target_owner = ledger_target_owner[3];
                    target_epoch = ledger_target_epoch[3];
                end
            endcase
            target_ready = (target_state == SLOT_READY);
        end
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
