numnahboom/rv32i_int8_dsc_cnn_accelerator/(commit log)

2026-06-08 Add multi-sample CPU RTL inference check
2026-08-21 Refine streaming CNN engine verification and synthesis flow
2026-08-23 Document current Stem pipeline implementation evidence
2026-08-23 Pipeline FC requantization product stage
2026-08-23 Pipeline Stem requantization into three stages
2026-08-23 Record current xc7z020 routed evidence
2026-09-06 feat(ds12): checkpoint verified streaming two-layer prototype
2026-10-19 Preserve verified D4 full-network FPGA prototype and portable inputs
2026-10-20 Record failed ASIC physical gate and explicit prototype criteria
